Nandorroloco/Nandofocus/BoM_and_build_NF814/20221215_180232[1].jpg

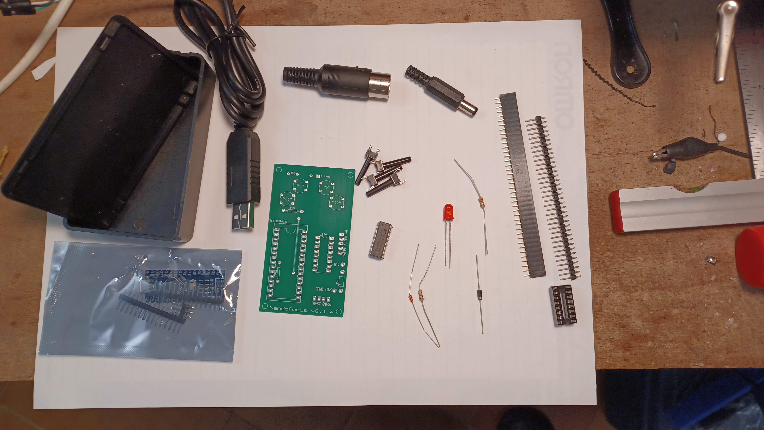
BoM_and_build_NF814/20221215_180232[1].jpg
