Nandorroloco/Nandofocus/README.md

# Nandofocus
Electronic focuser for telescopes. Robofocus compatible.

Content:
 "Tutorial montaje NandofocusV8.pdf": file in spanish language with all instructions that you need to build one NandofocusV8. Bill of Materials, Schematics, mounting instructions, shell wiring, programing instructions and starting.
 "Nandofocus8.ino" : Sketch for arduino.
 
 "/Adapting" some telecopes with an adaptation of electromechanicals devices for nandofocus.
 
 Nandofocus Version 8 based in Arduino.
 
 // 12-02-2022 new 8.1.3 version seeking speed is now MIDD (middle) because some drivers could lost steeps in FAST mode.
 
 // 29-10-2022 new version 8.1.4 backslach compensation issue fixed for Kstars/Ekos/Indi driver.
