Nandorroloco/Nandofocus/Adapting/Adaptacio_RC8.jpg

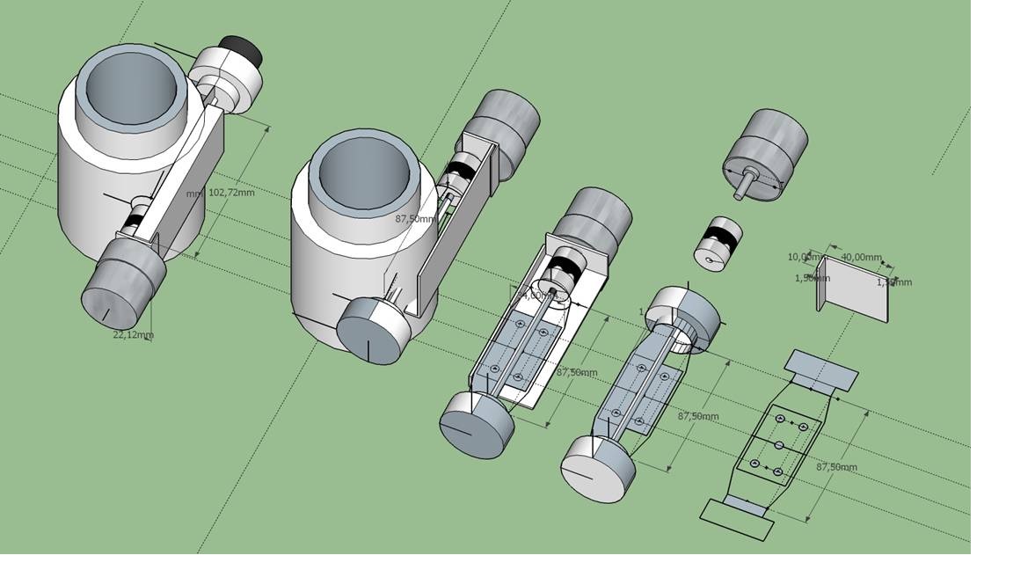
Adapting/Adaptacio_RC8.jpg
