Nandorroloco/Nandofocus/Adapting/IMG_20161104_201340 (1280x960).jpg

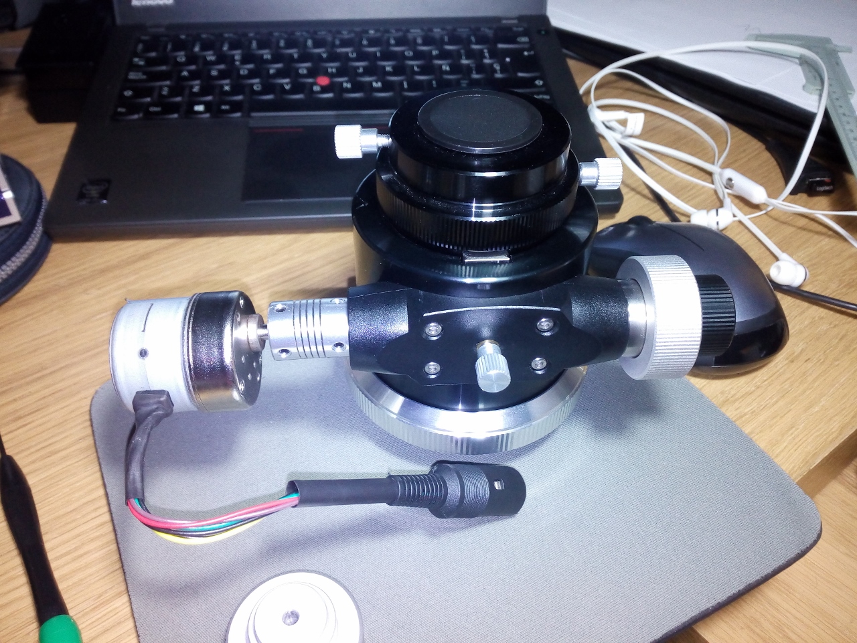
Adapting/IMG_20161104_201340 (1280x960).jpg
