Nandorroloco/Nandofocus/Adapting/IMG_20161208_204601 (960x1280).jpg

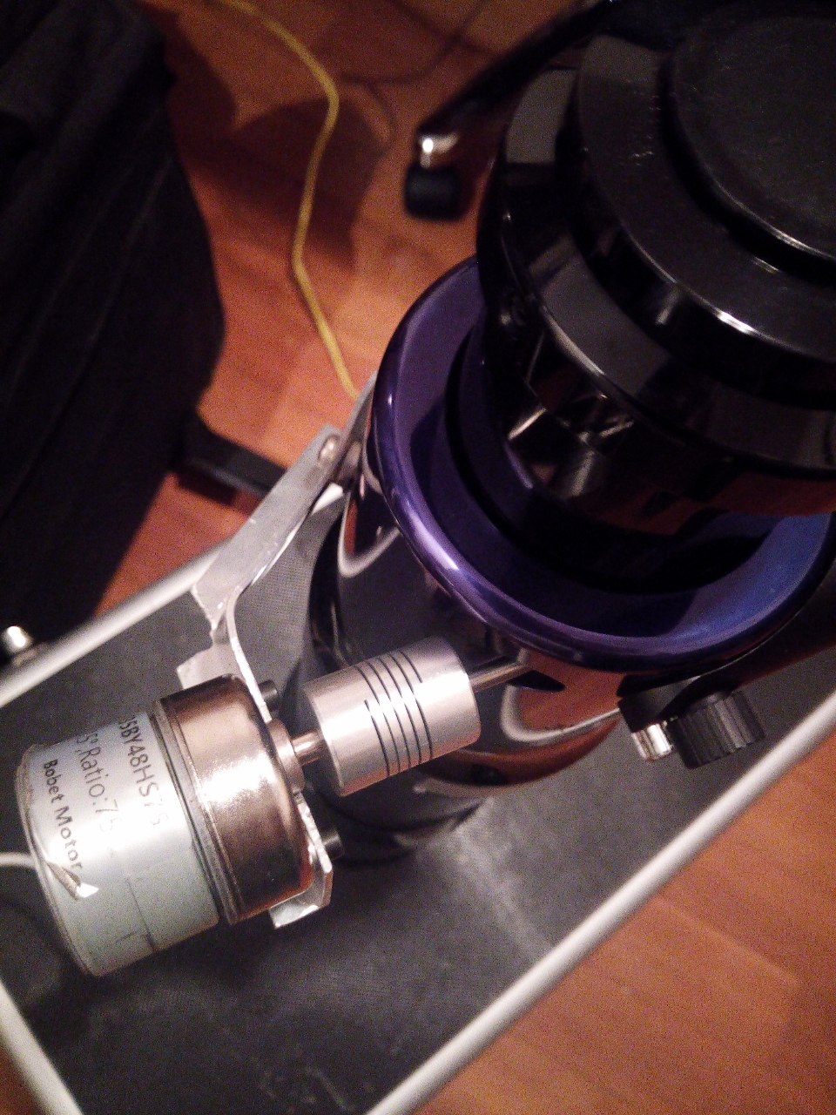
Adapting/IMG_20161208_204601 (960x1280).jpg
