Nandorroloco/Nandofocus/Adapting/Motor_PAP_bobet_1.jpg

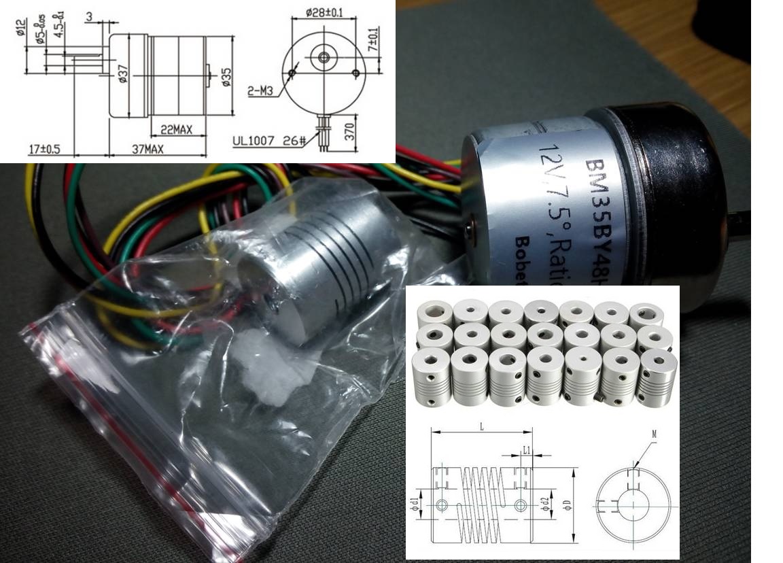
Adapting/Motor_PAP_bobet_1.jpg
