Nandorroloco/Nandofocus/PCB_Nandofocus814/PCB_Nandofocus814_print.pptx

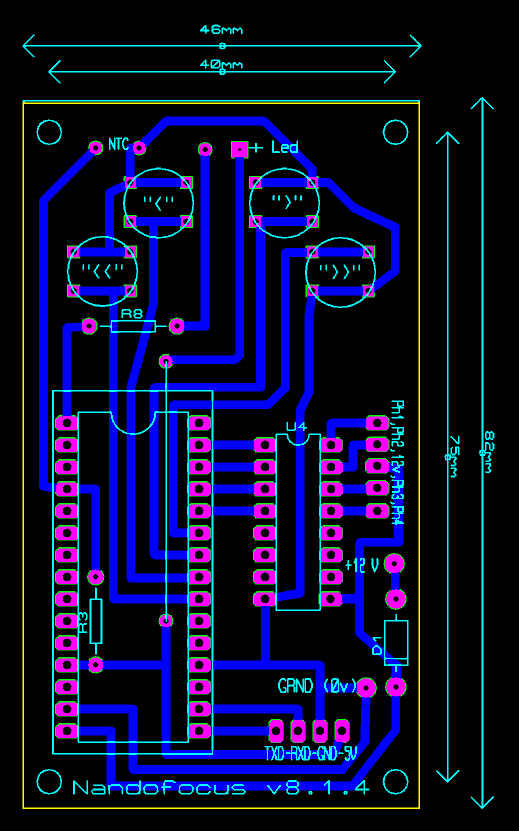
[picture p20: figure]
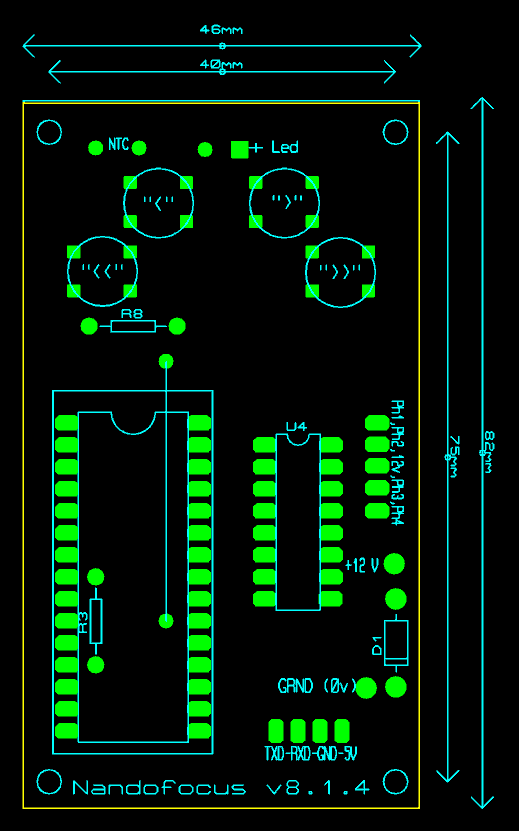
[picture p21: figure]

## Slide 2

Nandofocus v8.1.4
