Nandorroloco/Nandofocus/BoM_and_build_NF814/20221215_184130.jpg

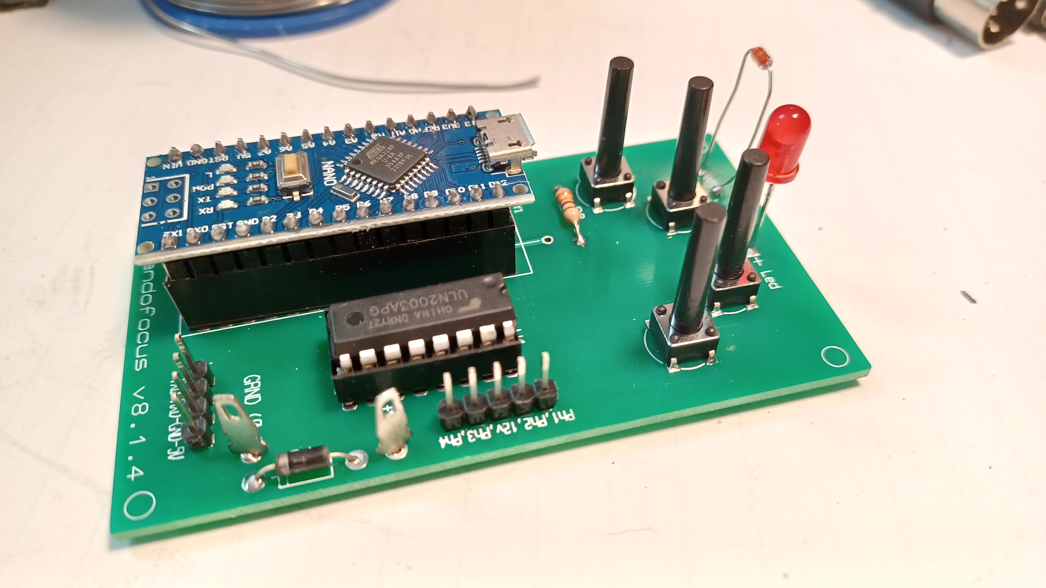
BoM_and_build_NF814/20221215_184130.jpg
