Nandorroloco/Nandofocus/BoM_and_build_NF814/20221215_184402.jpg

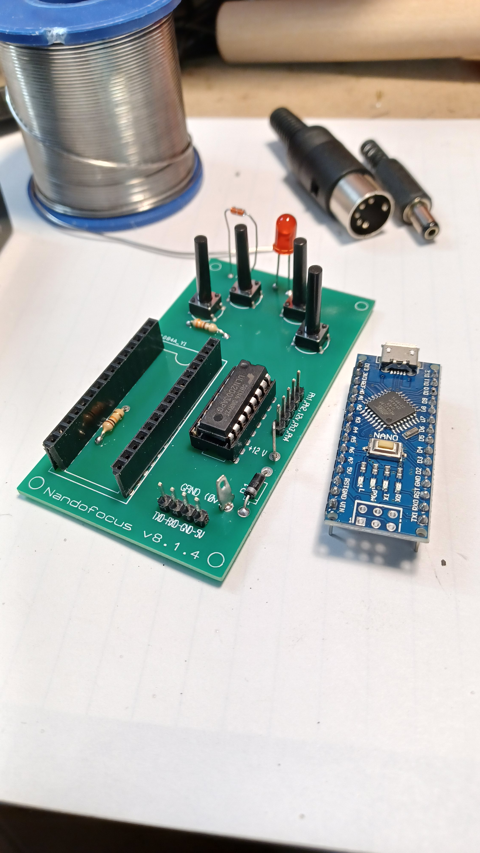
BoM_and_build_NF814/20221215_184402.jpg
