Nandorroloco/Nandofocus/(commit log)

2020-11-16 Add files via upload
    DIY focuser instructions in .pdf document
    Nandofocus8.ino firmware for Arduino.
2022-02-12 Add files via upload
    New version... with seeking speed slower (MIDD) that previous version (FAST). Some drivers are losing steeps at max speed. Slower but better :)
2022-10-29 Nandofocus as robotic focuser
    This repository was created with NandofocusV8 development. Absolute robotic focuser for telescopes, astrophotography oriented. Based on popular mcu Arduino (v8). Full compatible with Robofocus protocol (Open Source):
2022-12-15 PCB para NF814
    Subo los recursos para hacer una PCB para el Nandofocus v8.1.4
2022-12-21 Update Nandofocus8_1_4.ino
    Velocidad máxima, hay motores que pierden pasos... bajo la frecuencia
2022-12-22 Create 5141084A_Y1.rar
    Fichero de producción de JLCPCB
2022-12-23 documentación NF814
    Tutorial de montaje exhaustivo
2022-12-27 Create LecturaPosicionNF814.aia
    Es una aplicación Android desarrollada en el Mit App Inventor para leer la posición de un Nandofocus versión Bluetooth
2022-12-27 Update Tutorial_Montaje_NF814_v2.pdf
    direcciones de los botones
